rhit-zhouy21/Capstone-Project----Syringe-Pump/README.md

# Capstone-Project----Syringe-Pump
Capstone Project -- Syringe Pump
