rhit-zhouy21/Capstone-Project----Syringe-Pump/Initial Data/10000_flowRateTest1.csv

No | Date | Time | Timer | Mass | Unit | No2 | Scale No | Status | Note
1 | 2024-01-31 | 2024-01-31 11:19:42 AM | 0 | 96.3457 | g | 1 | 1 | 0
2 | 2024-01-31 | 2024-01-31 11:19:43 AM | 1 | 96.347 | g | 2 | 1 | 0
3 | 2024-01-31 | 2024-01-31 11:19:43 AM | 1 | 96.3479 | g | 3 | 1 | 0
4 | 2024-01-31 | 2024-01-31 11:19:44 AM | 2 | 96.3473 | g | 4 | 1 | 0
5 | 2024-01-31 | 2024-01-31 11:19:45 AM | 3 | 96.3358 | g | 5 | 1 | 0
6 | 2024-01-31 | 2024-01-31 11:19:45 AM | 3 | 96.3119 | g | 6 | 1 | 0
7 | 2024-01-31 | 2024-01-31 11:19:45 AM | 3 | 96.286 | g | 7 | 1 | 0
8 | 2024-01-31 | 2024-01-31 11:19:46 AM | 4 | 96.2566 | g | 8 | 1 | 0
9 | 2024-01-31 | 2024-01-31 11:19:46 AM | 4 | 96.2511 | g | 9 | 1 | 0
10 | 2024-01-31 | 2024-01-31 11:19:47 AM | 5 | 96.256 | g | 10 | 1 | 0
11 | 2024-01-31 | 2024-01-31 11:19:47 AM | 5 | 96.263 | g | 11 | 1 | 0
12 | 2024-01-31 | 2024-01-31 11:19:48 AM | 6 | 96.2695 | g | 12 | 1 | 0
13 | 2024-01-31 | 2024-01-31 11:19:48 AM | 6 | 96.2754 | g | 13 | 1 | 0
14 | 2024-01-31 | 2024-01-31 11:19:49 AM | 7 | 96.2815 | g | 14 | 1 | 0
15 | 2024-01-31 | 2024-01-31 11:19:49 AM | 7 | 96.2873 | g | 15 | 1 | 0
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
