rhit-zhouy21/Capstone-Project----Syringe-Pump/Initial Data/10000_flowRateTest2.csv

No | Date | Time | Timer | Mass | Unit | No2 | Scale No | Status | Note
1 | 2024-01-31 | 2024-01-31 11:26:05 AM | 0 | 88.93 | g | 1 | 1 | 0
2 | 2024-01-31 | 2024-01-31 11:26:05 AM | 0 | 88.9338 | g | 2 | 1 | 0
3 | 2024-01-31 | 2024-01-31 11:26:06 AM | 1 | 88.9348 | g | 3 | 1 | 0
4 | 2024-01-31 | 2024-01-31 11:26:06 AM | 1 | 88.9351 | g | 4 | 1 | 0
5 | 2024-01-31 | 2024-01-31 11:26:07 AM | 2 | 88.9365 | g | 5 | 1 | 0
6 | 2024-01-31 | 2024-01-31 11:26:07 AM | 2 | 88.9399 | g | 6 | 1 | 0
7 | 2024-01-31 | 2024-01-31 11:26:08 AM | 3 | 88.9446 | g | 7 | 1 | 0
8 | 2024-01-31 | 2024-01-31 11:26:08 AM | 3 | 88.9499 | g | 8 | 1 | 0
9 | 2024-01-31 | 2024-01-31 11:26:09 AM | 4 | 88.9565 | g | 9 | 1 | 0
10 | 2024-01-31 | 2024-01-31 11:26:09 AM | 4 | 88.9601 | g | 10 | 1 | 0
11 | 2024-01-31 | 2024-01-31 11:26:10 AM | 5 | 88.9622 | g | 11 | 1 | 0
12 | 2024-01-31 | 2024-01-31 11:26:10 AM | 5 | 88.9629 | g | 12 | 1 | 0
13 | 2024-01-31 | 2024-01-31 11:26:11 AM | 6 | 88.9627 | g | 13 | 1 | 0
14 | 2024-01-31 | 2024-01-31 11:26:11 AM | 6 | 88.9628 | g | 14 | 1 | 0
15 | 2024-01-31 | 2024-01-31 11:26:12 AM | 7 | 88.9639 | g | 15 | 1 | 0
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
