rhit-zhouy21/Capstone-Project----Syringe-Pump/Initial Data/1000_flowRateTest1.csv

No | Date | Time | Timer | Mass | Unit | No2 | Scale No | Status | Note
1 | 2024-01-29 | 2024-01-29 4:44:49 PM | 0 | 43.3506 | g | 1 | 1 | 0
2 | 2024-01-29 | 2024-01-29 4:44:49 PM | 0 | 43.3505 | g | 2 | 1 | 0
3 | 2024-01-29 | 2024-01-29 4:44:50 PM | 1 | 43.3504 | g | 3 | 1 | 0
4 | 2024-01-29 | 2024-01-29 4:44:50 PM | 1 | 43.3502 | g | 4 | 1 | 0
5 | 2024-01-29 | 2024-01-29 4:44:51 PM | 2 | 43.35 | g | 5 | 1 | 0
6 | 2024-01-29 | 2024-01-29 4:44:51 PM | 2 | 43.3499 | g | 6 | 1 | 0
7 | 2024-01-29 | 2024-01-29 4:44:52 PM | 3 | 43.3498 | g | 7 | 1 | 0
8 | 2024-01-29 | 2024-01-29 4:44:52 PM | 3 | 43.3498 | g | 8 | 1 | 0
9 | 2024-01-29 | 2024-01-29 4:44:53 PM | 4 | 43.3497 | g | 9 | 1 | 0
10 | 2024-01-29 | 2024-01-29 4:44:53 PM | 4 | 43.3496 | g | 10 | 1 | 0
11 | 2024-01-29 | 2024-01-29 4:44:54 PM | 5 | 43.3495 | g | 11 | 1 | 0
12 | 2024-01-29 | 2024-01-29 4:44:54 PM | 5 | 43.3493 | g | 12 | 1 | 0
13 | 2024-01-29 | 2024-01-29 4:44:55 PM | 6 | 43.3492 | g | 13 | 1 | 0
14 | 2024-01-29 | 2024-01-29 4:44:55 PM | 6 | 43.349 | g | 14 | 1 | 0
15 | 2024-01-29 | 2024-01-29 4:44:56 PM | 7 | 43.3488 | g | 15 | 1 | 0
16 | 2024-01-29 | 2024-01-29 4:44:56 PM | 7 | 43.3487 | g | 16 | 1 | 0
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
