rhit-zhouy21/Capstone-Project----Syringe-Pump/Initial Data/1000_flowRateTest2.csv

No | Date | Time | Timer | Mass | Unit | No2 | Scale No | Status | Note
1 | 2024-01-31 | 2024-01-31 10:29:45 AM | 0 | 103.8952 | g | 1 | 1 | 0
2 | 2024-01-31 | 2024-01-31 10:29:46 AM | 1 | 103.9028 | g | 2 | 1 | 0
3 | 2024-01-31 | 2024-01-31 10:29:46 AM | 1 | 103.9212 | g | 3 | 1 | 0
4 | 2024-01-31 | 2024-01-31 10:29:47 AM | 2 | 103.9587 | g | 4 | 1 | 0
5 | 2024-01-31 | 2024-01-31 10:29:47 AM | 2 | 104.0098 | g | 5 | 1 | 0
6 | 2024-01-31 | 2024-01-31 10:29:48 AM | 3 | 104.1617 | g | 6 | 1 | 0
7 | 2024-01-31 | 2024-01-31 10:29:48 AM | 3 | 104.3637 | g | 7 | 1 | 0
8 | 2024-01-31 | 2024-01-31 10:29:49 AM | 4 | 104.632 | g | 8 | 1 | 0
9 | 2024-01-31 | 2024-01-31 10:29:49 AM | 4 | 104.9368 | g | 9 | 1 | 0
10 | 2024-01-31 | 2024-01-31 10:29:50 AM | 5 | 105.2233 | g | 10 | 1 | 0
11 | 2024-01-31 | 2024-01-31 10:29:50 AM | 5 | 105.4944 | g | 11 | 1 | 0
12 | 2024-01-31 | 2024-01-31 10:29:51 AM | 6 | 105.7718 | g | 12 | 1 | 0
13 | 2024-01-31 | 2024-01-31 10:29:51 AM | 6 | 106.081 | g | 13 | 1 | 0
14 | 2024-01-31 | 2024-01-31 10:29:52 AM | 7 | 106.5531 | g | 14 | 1 | 0
15 | 2024-01-31 | 2024-01-31 10:29:52 AM | 7 | 106.9248 | g | 15 | 1 | 0
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
