rhit-zhouy21/Capstone-Project----Syringe-Pump/Initial Data/1500_flowRateTest1.csv

No | Date | Time | Timer | Mass | Unit | No2 | Scale No | Status | Note
1 | 2024-01-31 | 2024-01-31 10:31:19 AM | 0 | 104.0508 | g | 1 | 1 | 0
2 | 2024-01-31 | 2024-01-31 10:31:19 AM | 0 | 104.0561 | g | 2 | 1 | 0
3 | 2024-01-31 | 2024-01-31 10:31:20 AM | 1 | 104.0619 | g | 3 | 1 | 0
4 | 2024-01-31 | 2024-01-31 10:31:20 AM | 1 | 104.0716 | g | 4 | 1 | 0
5 | 2024-01-31 | 2024-01-31 10:31:21 AM | 2 | 104.1083 | g | 5 | 1 | 0
6 | 2024-01-31 | 2024-01-31 10:31:21 AM | 2 | 104.1789 | g | 6 | 1 | 0
7 | 2024-01-31 | 2024-01-31 10:31:22 AM | 3 | 104.3059 | g | 7 | 1 | 0
8 | 2024-01-31 | 2024-01-31 10:31:22 AM | 3 | 104.4886 | g | 8 | 1 | 0
9 | 2024-01-31 | 2024-01-31 10:31:23 AM | 4 | 104.7138 | g | 9 | 1 | 0
10 | 2024-01-31 | 2024-01-31 10:31:23 AM | 4 | 105.0443 | g | 10 | 1 | 0
11 | 2024-01-31 | 2024-01-31 10:31:24 AM | 5 | 105.2843 | g | 11 | 1 | 0
12 | 2024-01-31 | 2024-01-31 10:31:25 AM | 6 | 105.5145 | g | 12 | 1 | 0
13 | 2024-01-31 | 2024-01-31 10:31:25 AM | 6 | 105.7327 | g | 13 | 1 | 0
14 | 2024-01-31 | 2024-01-31 10:31:25 AM | 6 | 105.9462 | g | 14 | 1 | 0
15 | 2024-01-31 | 2024-01-31 10:31:26 AM | 7 | 106.1677 | g | 15 | 1 | 0
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
