rhit-zhouy21/Capstone-Project----Syringe-Pump/Initial Data/1500_flowRateTest2.csv

No | Date | Time | Timer | Mass | Unit | No2 | Scale No | Status | Note
1 | 2024-01-31 | 2024-01-31 10:32:56 AM | 0 | 104.3288 | g | 1 | 1 | 0
2 | 2024-01-31 | 2024-01-31 10:32:57 AM | 1 | 104.4451 | g | 2 | 1 | 0
3 | 2024-01-31 | 2024-01-31 10:32:57 AM | 1 | 104.6262 | g | 3 | 1 | 0
4 | 2024-01-31 | 2024-01-31 10:32:58 AM | 2 | 104.8549 | g | 4 | 1 | 0
5 | 2024-01-31 | 2024-01-31 10:32:58 AM | 2 | 105.1064 | g | 5 | 1 | 0
6 | 2024-01-31 | 2024-01-31 10:32:59 AM | 3 | 105.4291 | g | 6 | 1 | 0
7 | 2024-01-31 | 2024-01-31 10:32:59 AM | 3 | 105.6401 | g | 7 | 1 | 0
8 | 2024-01-31 | 2024-01-31 10:33:00 AM | 4 | 105.8237 | g | 8 | 1 | 0
9 | 2024-01-31 | 2024-01-31 10:33:00 AM | 4 | 105.9709 | g | 9 | 1 | 0
10 | 2024-01-31 | 2024-01-31 10:33:01 AM | 5 | 106.1236 | g | 10 | 1 | 0
11 | 2024-01-31 | 2024-01-31 10:33:01 AM | 5 | 106.3021 | g | 11 | 1 | 0
12 | 2024-01-31 | 2024-01-31 10:33:02 AM | 6 | 106.51 | g | 12 | 1 | 0
13 | 2024-01-31 | 2024-01-31 10:33:02 AM | 6 | 106.7555 | g | 13 | 1 | 0
14 | 2024-01-31 | 2024-01-31 10:33:03 AM | 7 | 107.1018 | g | 14 | 1 | 0
15 | 2024-01-31 | 2024-01-31 10:33:03 AM | 7 | 107.3608 | g | 15 | 1 | 0
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
